pixelPerfect-lab/Hackropad/README.md

# Hackropad
The hackropad is a 3 key macropad with a rotary encoder. It connects to your PC with a USB type B cable, and is very compact. I designed this over 11 and a half hours, and in my opinion looks acceptable.
Part	| What it's for	| Qty	| Unit	| Total |	Vendor
--------|---|---|---|---|---
RP2040 | MCU | 1 | $0.76 | $0.76 | DigiKey
4Mb flash memory | Flash memory for raspberry pi | 1	| $1.34	| $1.34 |	DigiKey
3.3V voltage regulator | Micro USB type b power |	1	| $0.62	| $0.62 |	DigiKey
Micro-USB connector	| Connection to PC and power |	1	| $0.81 |	$0.81 |	DigiKey
Rotary encoder with push button |	Rotary Encoder input | 1 |	$2.69 |	$2.69 |	DigiKey
Cherry MX2A Brown keyboard switch |	Button inputs |	3 |	$1.75 |	$5.25 |	DigiKey
Momentary reset switch |	Resetting the Raspberry Pi |	1 |	$0.35 |	$0.35 |	DigiKey
2-pin header, 2.54 mm	| Short to boot	| 1	| $0.21 |	$0.21 |	DigiKey
12 MHz crystal |	Crystal for clocking the RP2040	| 1 | 	$0.69 |	$0.69 |	DigiKey
Passive Components |	Capacitors and resistors (80 total per set) |	1	| $4.55 |	$4.55 |	DigiKey
Parts subtotal |	—	| —	| — |	$17.27 |	—
Tax & shipping	| —	| — |	— |	$0.00 |	—
Total |	—	| —	| —	| $17.27 |	—




https://cad.onshape.com/documents/e98056e3a4491591a6f8bf1e/w/48743fa81ab57436ecb89123/e/8a25d650e3180fe18e477bea

Half-Life is a 10 week long hardware adventure, where teens aged 13-18 can learn about how to create and ship various projects, with rewards along side it, up to 100 dollars of project funding, and a 3D printer as a final reward.
