pixelPerfect-lab/Hackropad/BOM.md

# Hackropad – bill of materials

<!-- Generated by Half Life from project cmuutokyp0aew01sm8pcrkiiz. Edits here are overwritten on the next sync. -->
<!-- Generated: 2026-10-11T09:45:58.785Z -->

> [!NOTE]
> This parts list is mirrored from [Half Life](https://halflife.hackclub.com). Editing it here will not change the platform's copy, and the next sync overwrites this file.

| Week | Tier | Parts funding |
| --- | --- | --- |
| Week 1 | Tier 1 | $30.00 |

| Part | What it's for | Qty | Unit | Total | Vendor |
| --- | --- | --- | --- | --- | --- |
| [RP2040](https://www.digikey.com.au/en/products/detail/raspberry-pi/SC0914-13/14306010) | MCU | 1 | $0.76 | $0.76 | [DigiKey](https://www.digikey.com.au/en/products/detail/raspberry-pi/SC0914-13/14306010) |
| [4Mb flash memory](https://www.digikey.com.au/en/products/detail/gigadevice-electronics-singapore-pte-ltd/GD25Q32ESIGR/14113859) | Flash memory for raspberry pi | 1 | $1.34 | $1.34 | [DigiKey](https://www.digikey.com.au/en/products/detail/gigadevice-electronics-singapore-pte-ltd/GD25Q32ESIGR/14113859) |
| [3.3V voltage regulator](https://www.digikey.com.au/en/products/detail/onsemi/NCP1117ST33T3G/1749063) | Micro USB type b power | 1 | $0.62 | $0.62 | [DigiKey](https://www.digikey.com.au/en/products/detail/onsemi/NCP1117ST33T3G/1749063) |
| [Micro-USB connector](https://www.digikey.com.au/en/products/detail/amphenol-cs-fci/10103594-0001LF/2350351) | Connection to PC and power | 1 | $0.81 | $0.81 | [DigiKey](https://www.digikey.com.au/en/products/detail/amphenol-cs-fci/10103594-0001LF/2350351) |
| [Rotary encoder with push button](https://www.digikey.com.au/en/products/detail/bourns-inc/PEC11R-4220F-S0024/4499660) | Rotary Encoder input | 1 | $2.69 | $2.69 | [DigiKey](https://www.digikey.com.au/en/products/detail/bourns-inc/PEC11R-4220F-S0024/4499660) |
| [Cherry MX2A Brown keyboard switch](https://www.digikey.com.au/en/products/detail/cherry-americas-llc/MX2A-G1NB/21738375) | Button inputs | 3 | $1.75 | $5.25 | [DigiKey](https://www.digikey.com.au/en/products/detail/cherry-americas-llc/MX2A-G1NB/21738375) |
| [Momentary reset switch](https://www.digikey.com.au/en/products/detail/aratas-formerly-omron-components/B3F-1000/33150) | Resetting the Raspberry Pi | 1 | $0.35 | $0.35 | [DigiKey](https://www.digikey.com.au/en/products/detail/aratas-formerly-omron-components/B3F-1000/33150) |
| [2-pin header, 2.54 mm](https://www.digikey.com.au/en/products/detail/samtec-inc/TSW-102-07-G-S/1101325) | Short to boot | 1 | $0.21 | $0.21 | [DigiKey](https://www.digikey.com.au/en/products/detail/samtec-inc/TSW-102-07-G-S/1101325) |
| [12 MHz crystal](https://www.digikey.com.au/en/products/detail/abracon-llc/ABM8-272-T3/22472366) | Crystal for clocking the RP2040 | 1 | $0.69 | $0.69 | [DigiKey](https://www.digikey.com.au/en/products/detail/abracon-llc/ABM8-272-T3/22472366) |
| [Passive Components](https://www.digikey.com.au) | Capacitors and resistors (80 total per set) | 1 | $4.55 | $4.55 | [DigiKey](https://www.digikey.com.au) |
| **Parts subtotal** | — | — | — | **$17.27** | — |
| **Tax & shipping** | — | — | — | **$0.00** | — |
| **Total** | — | — | — | **$17.27** | — |

$12.73 left of the tier's funding.
