pixelPerfect-lab/Hackropad/HackroPad/HackroPad.step

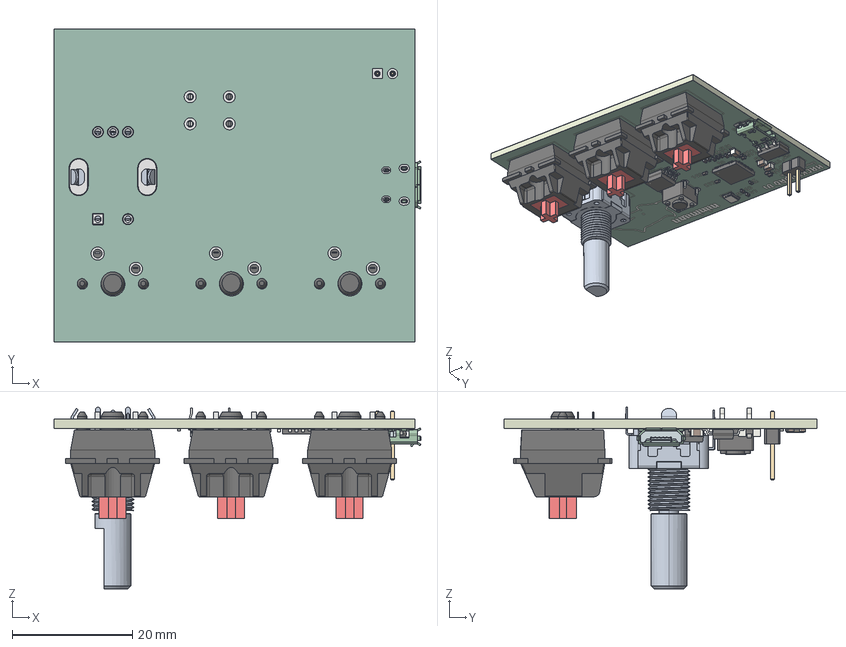
[picture p1: CAD file, 2026-10-11]
HackroPad/HackroPad.step
61.0 x 52.0 x 30.2 mm
C_0402_1005Metric x 14
R_0402_1005Metric x 4
C_0805_2012Metric x 3
QFN-56-1EP_7x7mm_P0.4mm_EP3.2x3.2mm
PEC11-4220F-S0024
10103594_AFCI_SW0001
SOIC-8_5.3x5.3mm_P1.27mm
Crystal_SMD_3225-4Pin_3.2x2.5mm
SOT-223
PinHeader_1x02_P254mm_Vertical
SW_PUSH_6mm
Hac99BC_copper
Hac99BC_pad
Hac99BC_via
Hac99BC_silkscreen
Hac99BC_soldermask x 2
Hac99BC_PCB
