pixelPerfect-lab/Hackropad/HackroPad/HackroPad.kicad_pcb

## KiCad design HackroPad/HackroPad.kicad_pcb (2026-10-11)

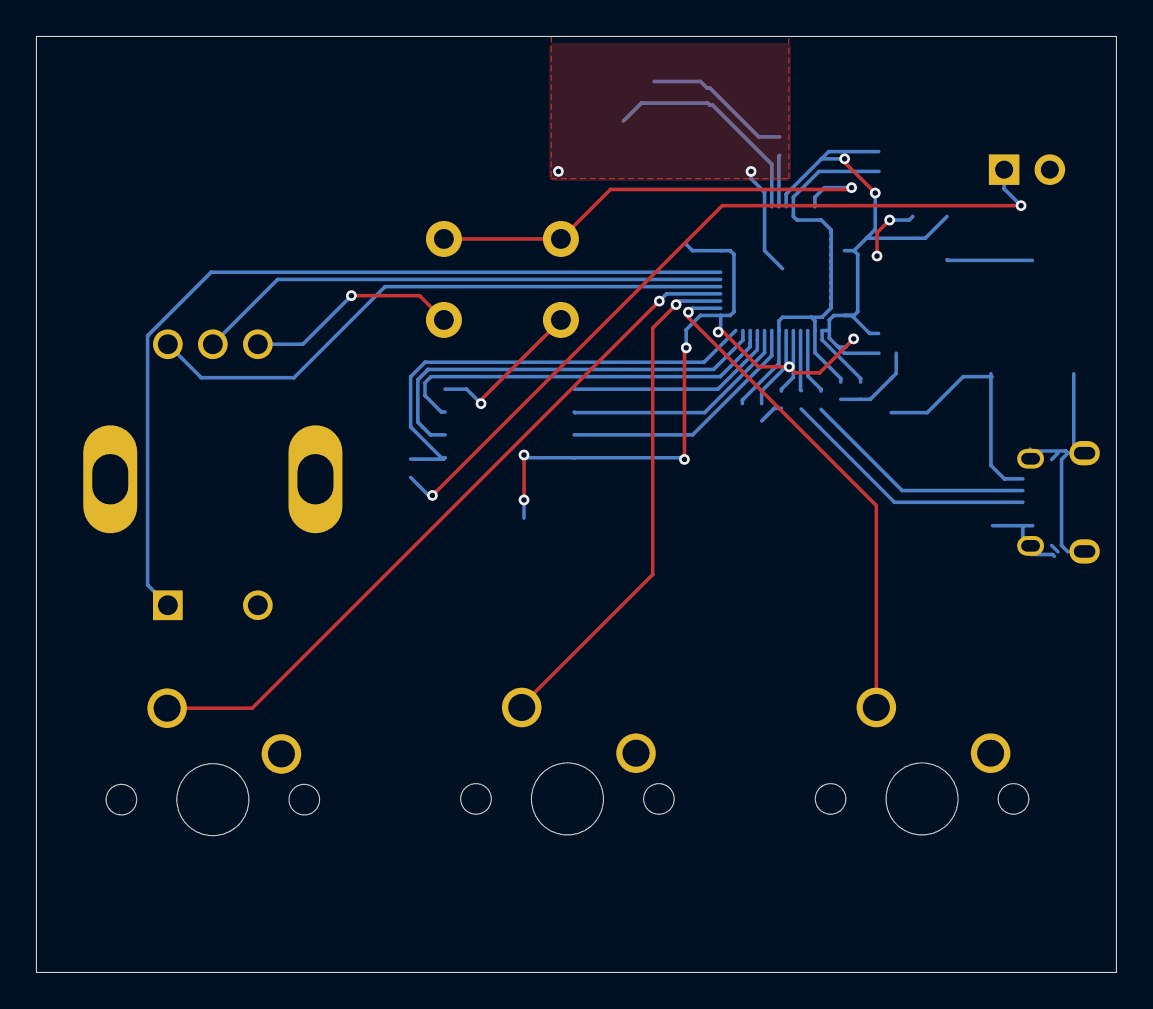
[picture p2: board HackroPad.kicad_pcb from above]

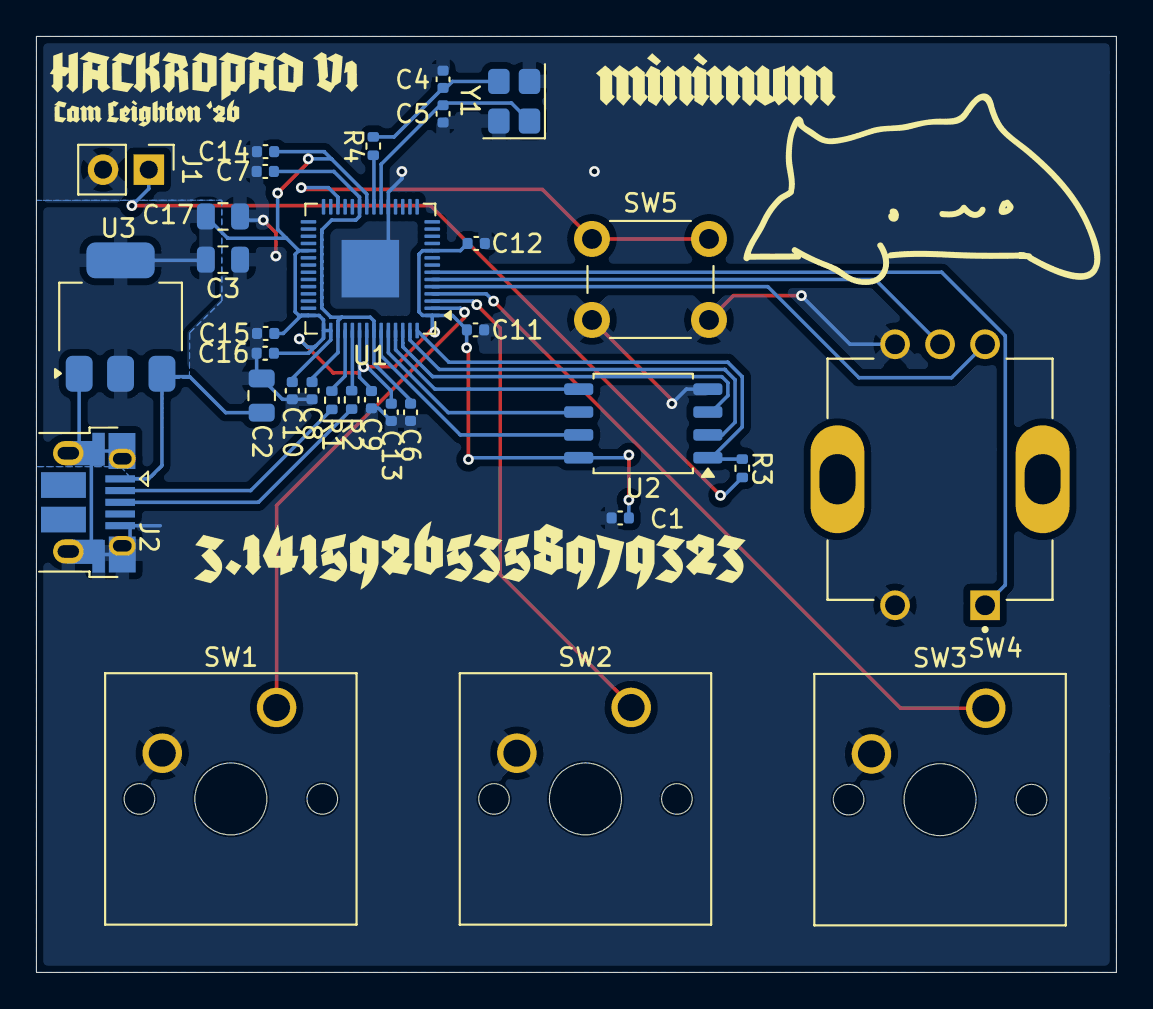
[picture p3: board HackroPad.kicad_pcb from below]

Board: 2 copper layers, 60.0 x 52.0 mm, 32 parts (32 on the bottom side), 25 nets.

Parts:
C1, C6, C7, C9, C11, C12, C13, C14, C15, C16: 100n; C_0402_1005Metric
C2, C3, C17: 10u; C_0805_2012Metric
C4, C5: 15p; C_0402_1005Metric
C8, C10: 1u; C_0402_1005Metric
J1: TSW-102-07-G-S; PinHeader_1x02_P2.54mm_Vertical
J2: 10103594-0001LF; USB_Micro-B_Amphenol_10103594-0001LF_Horizontal
R1, R2: 27; R_0402_1005Metric
R3, R4: 1k; R_0402_1005Metric
SW1, SW2, SW3: Cherry MX2A; SW_Cherry_MX_1.00u_PCB
SW4: PEC11R-4220F-S0024-ND; XDCR_PEC11R-4220F-S0024
SW5: Momentary; SW_PUSH_6mm
U1: RP2040; QFN-56-1EP_7x7mm_P0.4mm_EP3.2x3.2mm
U2: W25Q32JVSS; SOIC-8_5.3x5.3mm_P1.27mm
U3: NCP1117ST33T3G; SOT-223-3_TabPin2
Y1: 12MHz; Crystal_SMD_3225-4Pin_3.2x2.5mm

Connections:
+1V1: C6.1, C7.1, C8.1, U1.23 (DVDD), U1.45 (VREG_VOUT), U1.50 (DVDD)
+3V3: C1.1, C3.1, C9.1, C10.1, C11.1, C12.1, C13.1, C14.1, C15.1, C16.1, C17.1, U1.1 (IOVDD), U1.10 (IOVDD), U1.22 (IOVDD), U1.33 (IOVDD), U1.42 (IOVDD), U1.43 (ADC_AVDD), U1.44 (VREG_VIN), U1.48 (USB_VDD), U1.49 (IOVDD), U2.8 (VCC), U3.2 (VO)
/GPIO0: SW1.1, U1.2 (GPIO0)
/GPIO1: SW2.1, U1.3 (GPIO1)
/GPIO2: SW3.1, U1.4 (GPIO2)
/GPIO3: SW4.A, U1.5 (GPIO3)
/GPIO4: SW4.C, U1.6 (GPIO4)
/GPIO5: SW4.1, U1.7 (GPIO5)
/QSPI_SCLK: U1.52 (QSPI_SCLK), U2.6 (CLK)
/QSPI_SD0: U1.53 (QSPI_SD0), U2.5 (DI/IO_{0})
/QSPI_SD1: U1.55 (QSPI_SD1), U2.2 (DO/IO_{1})
/QSPI_SD2: U1.54 (QSPI_SD2), U2.3 (~WP/IO_{2})
/QSPI_SD3: U1.51 (QSPI_SD3), U2.7 (~HOLD/~RESET/IO_{3})
/QSPI_SS: R3.2, U1.56 (~QSPI_SS), U2.1 (~CS)
/RUN: SW5.1, U1.26 (RUN)
/USB_D+: J2.3 (D+), R2.1
/USB_D-: J2.2 (D-), R1.1
/XIN: C5.2, U1.20 (XIN), Y1.1
/XOUT: R4.2, U1.21 (XOUT)
GND: C1.2, C2.2, C3.2, C4.1, C5.1, C6.2, C7.2, C8.2, C9.2, C10.2, C11.2, C12.2, C13.2, C14.2, C15.2, C16.2, C17.2, J1.2, J2.5 (GND), J2.SH (Shield), SW1.2, SW2.2, SW3.2, SW4.2, SW4.B, SW5.2, U1.19 (TESTEN), U1.57 (GND), U2.4 (GND), U3.1 (GND), Y1.2 (G), Y1.4 (G)
unnamed: C4.2, R4.1, Y1.3
unnamed: J1.1, R3.1
unnamed: R1.2, U1.46 (USB_DM)
unnamed: R2.2, U1.47 (USB_DP)
VBUS: C2.1, J2.1 (VBUS), U3.3 (VI)
