pixelPerfect-lab/Hackropad/JOURNAL.md

# Hackropad – devlog

<!-- Generated by Half Life from project cmuutokyp0aew01sm8pcrkiiz. Edits here are overwritten on the next sync. -->
<!-- Generated: 2026-10-11T09:51:12.249Z -->

> [!NOTE]
> This devlog is mirrored from [Half Life](https://halflife.hackclub.com). Editing it here will not change the platform's copy, and the next sync overwrites this file.

> A 3 key macropad with a rotary encoder and an OLED display, as well as bluetooth connectivity.

| Week | Tier | Hours logged | Entries |
| --- | --- | --- | --- |
| Week 1 | Tier 1 | 12h | 6 |

## Contents

1. [2026-10-05 – This is more of a note to self, I am refrencing this document to wire up the MCU. I am hoping to do the chip myself to save on space, and this document seems helpful.](#2026-10-05-this-is-more-of-a-note-to-self-i-am-refrencing-th)
2. [2026-10-05 – https://www.digikey.com.au/short/7r1d533t](#2026-10-05-httpswwwdigikeycomaushort7r1d533t)
3. [2026-10-07 – ](#2026-10-07-imagehttpshalflifehackclub-assetscomhackclub-half)
4. [2026-10-08 – Trace her? But I hardly know her!](#2026-10-08-trace-her-but-i-hardly-know-her)
5. [2026-10-11 – Final session!](#2026-10-11-final-session)
6. [2026-10-11 – Set up QMK firmware](#2026-10-11-set-up-qmk-firmware)

## Design

### 2026-10-05 – This is more of a note to self, I am refrencing this document to wire up the MCU. I am hoping to do the chip myself to save on space, and this document seems helpful.

**0.02h**

This is more of a note to self, I am refrencing this document to wire up the MCU. I am hoping to do the chip myself to save on space, and this document seems helpful.
https://tinyurl.com/yxp5nkf7 <= is the official Hardware design with RP2040 from Raspberry Pi, and it is quite well written!


^^is the first page of the pdf, as well as the full link if you don't feel safe clicking the shortened one.


^^the full schematic that I am referencing!
Have a great day, and enjoy my minimum length entry!

### 2026-10-05 – https://www.digikey.com.au/short/7r1d533t

**1.5h**

https://www.digikey.com.au/short/7r1d533t
I am probably not going to get the parts from DigiKey, as they charge a huge amount for shipping ($24 AUD) and without the rotary encoder or cherry keys, my total is $10.85 which is pretty nice.


^^It takes soooo long to find the right components 😔 and I can't even count the time :( :(


^^only a few tabs for components, and I closed a lot
Also the time lapses are not working for some reason, but I did some tutorials for KiCad.

### 2026-10-07 – 

**2.48h**


^^RP2040 stuff dealt with!!!! This is about 1 hr 30 minutes of work so far, and I just need to get in the rotary encoder and 3 keys!

^^Everything in now! Spent some time finding appropriate footprints too (~30 minutes of work), so now I just need to get those linked up to the schematic and then I can start the PCB!
I don't quite know what Cherry switches to go for; I have been told that the brown ones are the way to go.

^^Footprints assigned, that took another 30 odd minutes
Productive session, I would say! (the reason why it is 2.48 is because I used a session to make a note to self for the RP2040 hardware guide, and the minimum time allotment is 0.02 hours)

### 2026-10-08 – Trace her? But I hardly know her!

**3h**

Trace her? But I hardly know her!

^^The pcb without the edges is around 61mm x 51mm
Today I wanted to do all of the traces, but I severely underestimated the time requirements of doing so. When I started I thought that this task would take about an hour or so, and thus I was not expecting to dump 3 hours into it. To be fair I am just learning though, although I hope I do get faster...

I am yet to put the big ground and +3v3 copper areas (IDK what they are called) down, but otherwise I think the board is looking really nice. I am really proud of how compact I made it, at the cost of hours of my day. In the future I would almost certainly go with the already made pico 2, but making this was a vital experience in terms of how those boards actually work.

Understandably, DRC is throwing a hissy fit, although most, if not all, of those errors will be resolved by putting in the area thingies (still don't know what they are called).
TLDR: Did 90% of the PCB, and severely underestimated time costs...

### 2026-10-11 – Final session!

**4h**

Final session!

So yesterday (I am writing this the day after because I didn't have the energy to record a reel yesterday) I decided that I was going to lock in and get this complete. So, with the power of ADHD hyperfocus, I completed a large amount of work.


As you can see, I decided to (later regretting the following decision) use illustrator to design the silkscreen art. It is nothing special, but it does feature that weird blob cat thingy, which I like. I am proud of it, and the font I chose is kinda interesting.

^^Good luck reading this word :)
It looked OK after I added it to the PCB, and the elements I designed fit well onto the empty spaces on the board.

I did follow a tutorial to get it to export from illustrator in the right format and subsequently upload it to KiCAD, but I think it was worth the effort to do so!

After all of that, I wanted a nice render of the board, so I used blender to do so. I went from this pretty bad looking one from KiCAD's built in renderer to a nice looking render after a little bit of effort.



To get the render, I had to go through a few steps. First, I had to export the board as a GLB file from KiCAD and then move it over to blender (pretty simple). Then I placed down a solid mesh to serve as the floor, then set up 2 lights to point at the PCB from different angles and with different brightnesses. I originally had them way to bright, leading to the board looking whitewashed, but after I turned them down they looked a lot better. Finally, I had to set up the camera angle so that I could get the right kind of shot.


All in all, I am really proud of the work that I put into this project, and the skills I learnt with KiCAD and blender are going to be really valuable in the future. I think that the end result, while slightly less than I imagined, feels like an achievement, and I think that getting to put this together will be really fun.

### 2026-10-11 – Set up QMK firmware

**1h**

Set up QMK firmware




So to do this I had to follow a tutorial, it was pretty bad, but I got there in the end. I bound the 3 keys to F13-15, and the rotary encoder to do volume (and the button on it to mute/unmute).
