pixelPerfect-lab/Hackropad/(commit log)

2026-10-11 Enhance README with hackropad design details
    Added additional details about the hackropad design and materials.
2026-10-11 All of the KiCAD stuff!
2026-10-11 Drill files
2026-10-23 Add Bill of Materials (BOM) for project components
